Dreathwings/ESC/V1/V1.1_calque.pdf

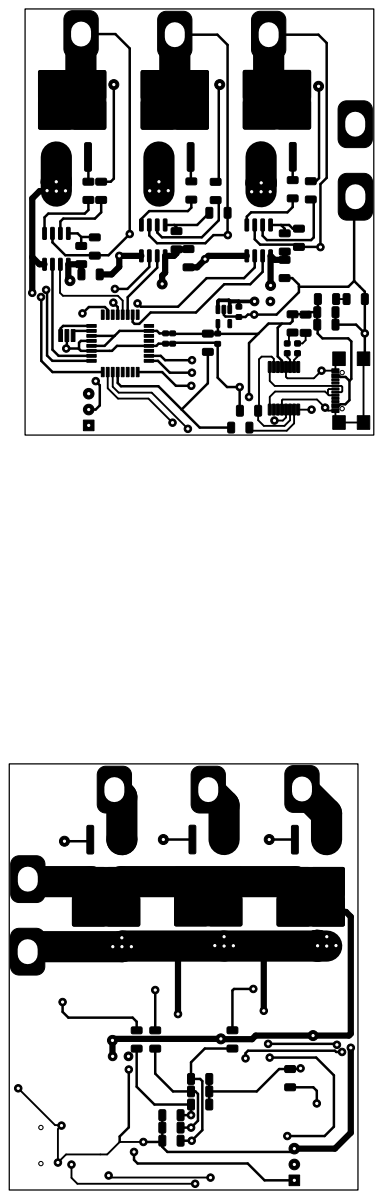
[picture p1: page 1]
