Dreathwings/ESC/V1/ESC_V1-B_Cu.pdf

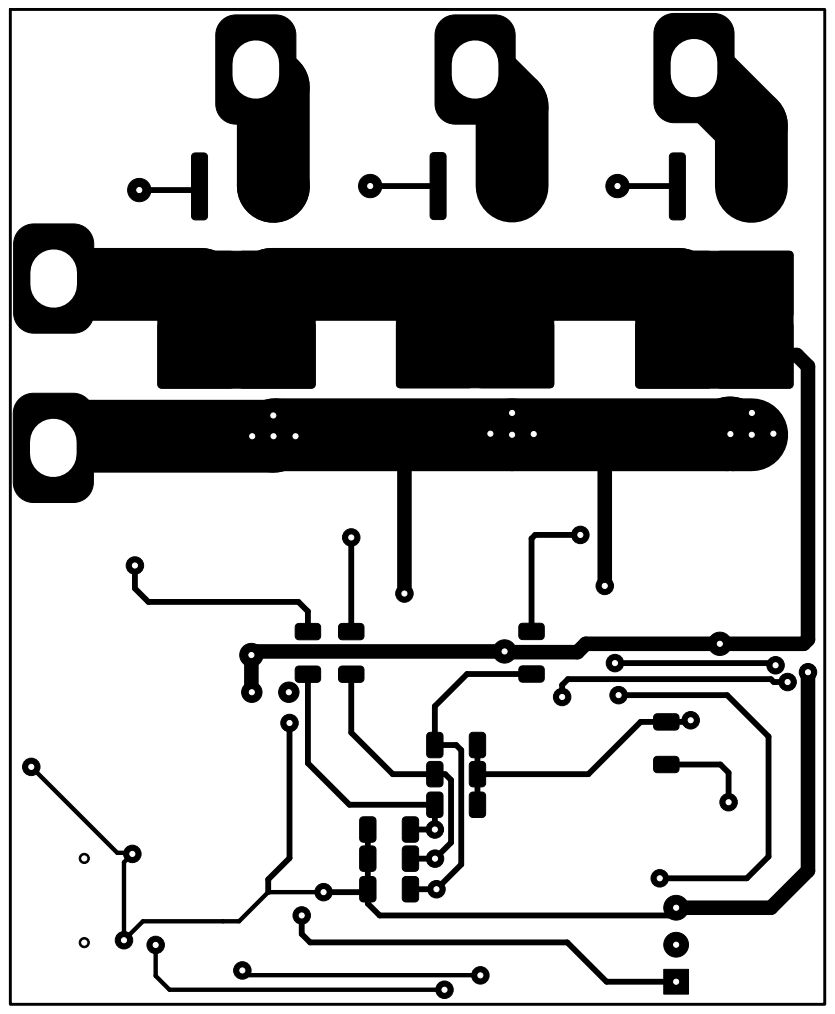
[picture p2: page 1]
