Dreathwings/ESC/V1/ESC_V1-B_Fab.pdf

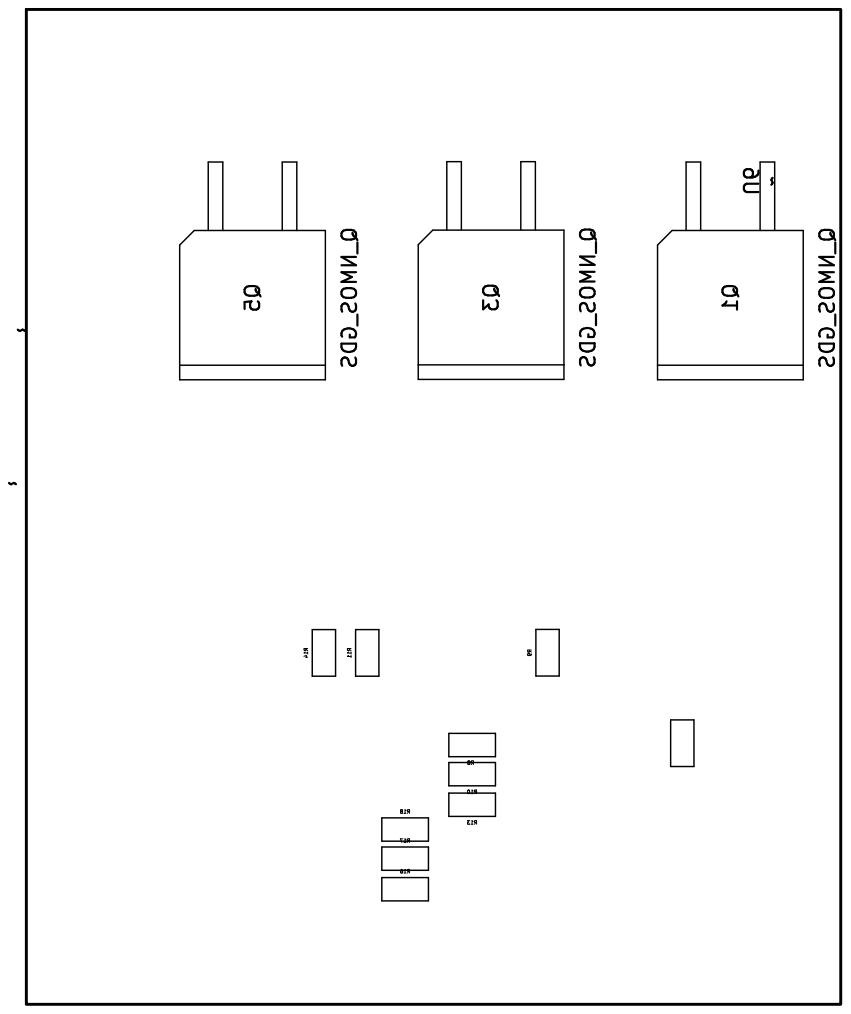
[picture p3: page 1]
