Dreathwings/ESC/V1/ESC_V1-F_Cu.pdf

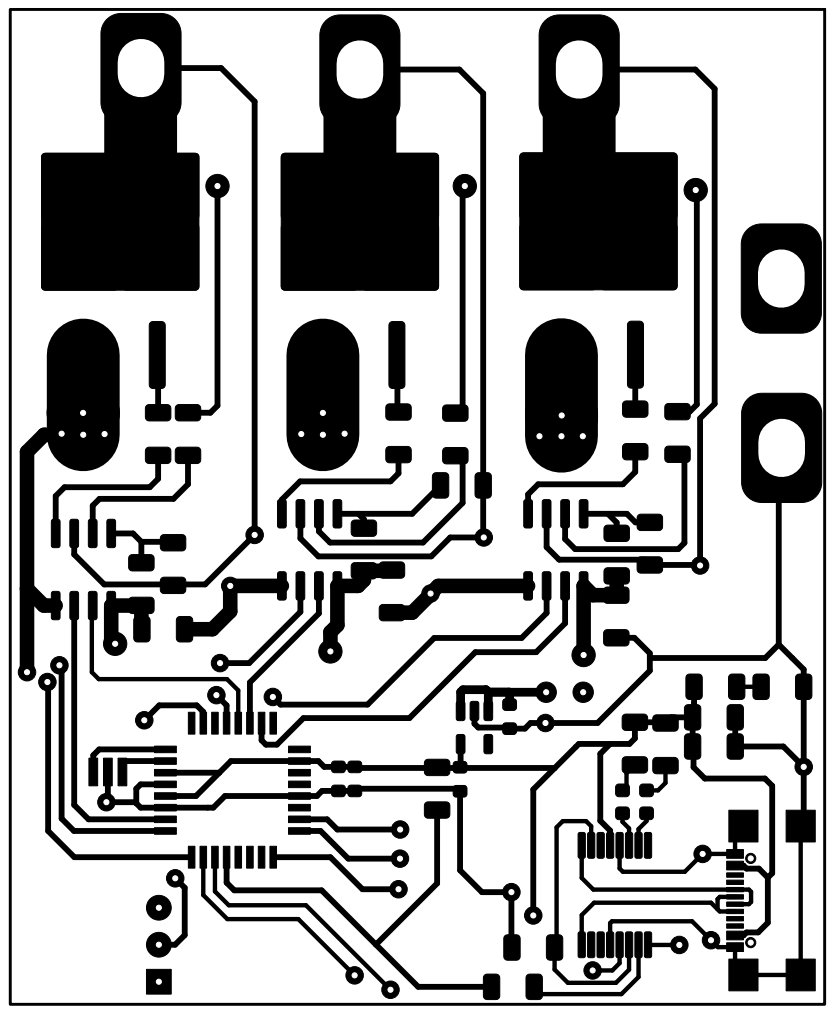
[picture p4: page 1]
