Dreathwings/ESC/V1/ESC_V1-F_Fab.pdf

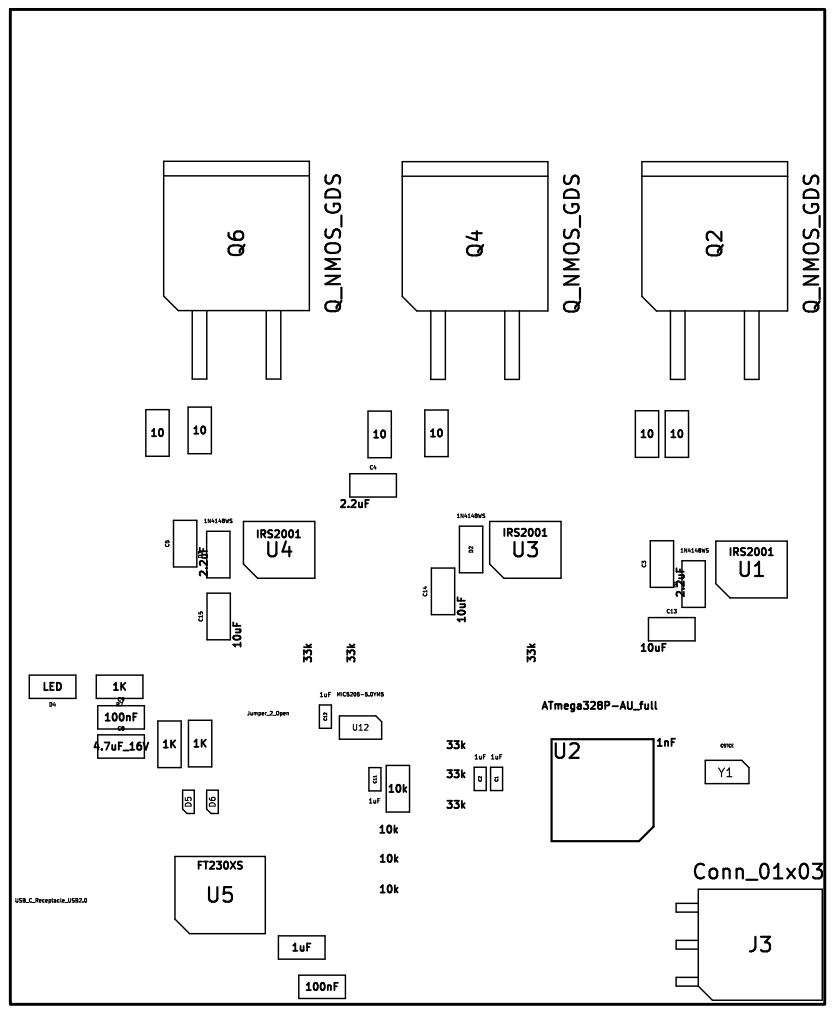
[picture p5: page 1]
