Dreathwings/ESC/V1/ESC_V1-Edge_Cuts.pdf

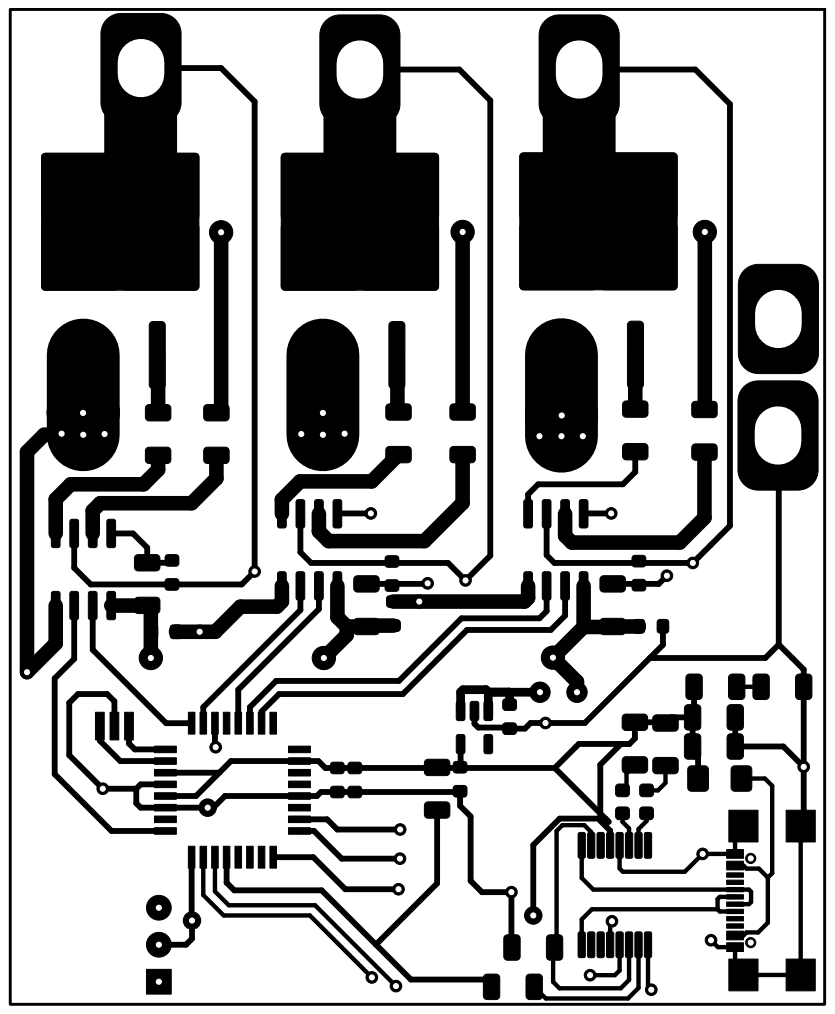
[picture p6: page 1]
