Dreathwings/ESC/V1/V1_calque.pdf

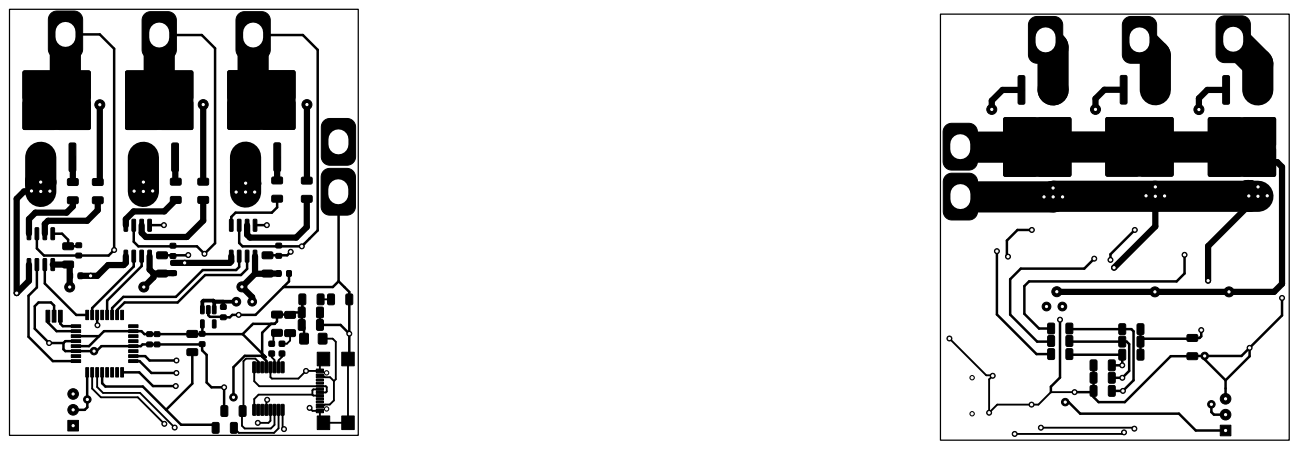
[picture p7: page 1]
