Dreathwings/ESC/V1/ESC_V1.kicad_pcb

## KiCad design V1/ESC_V1.kicad_pcb (2024-07-09, an earlier design)

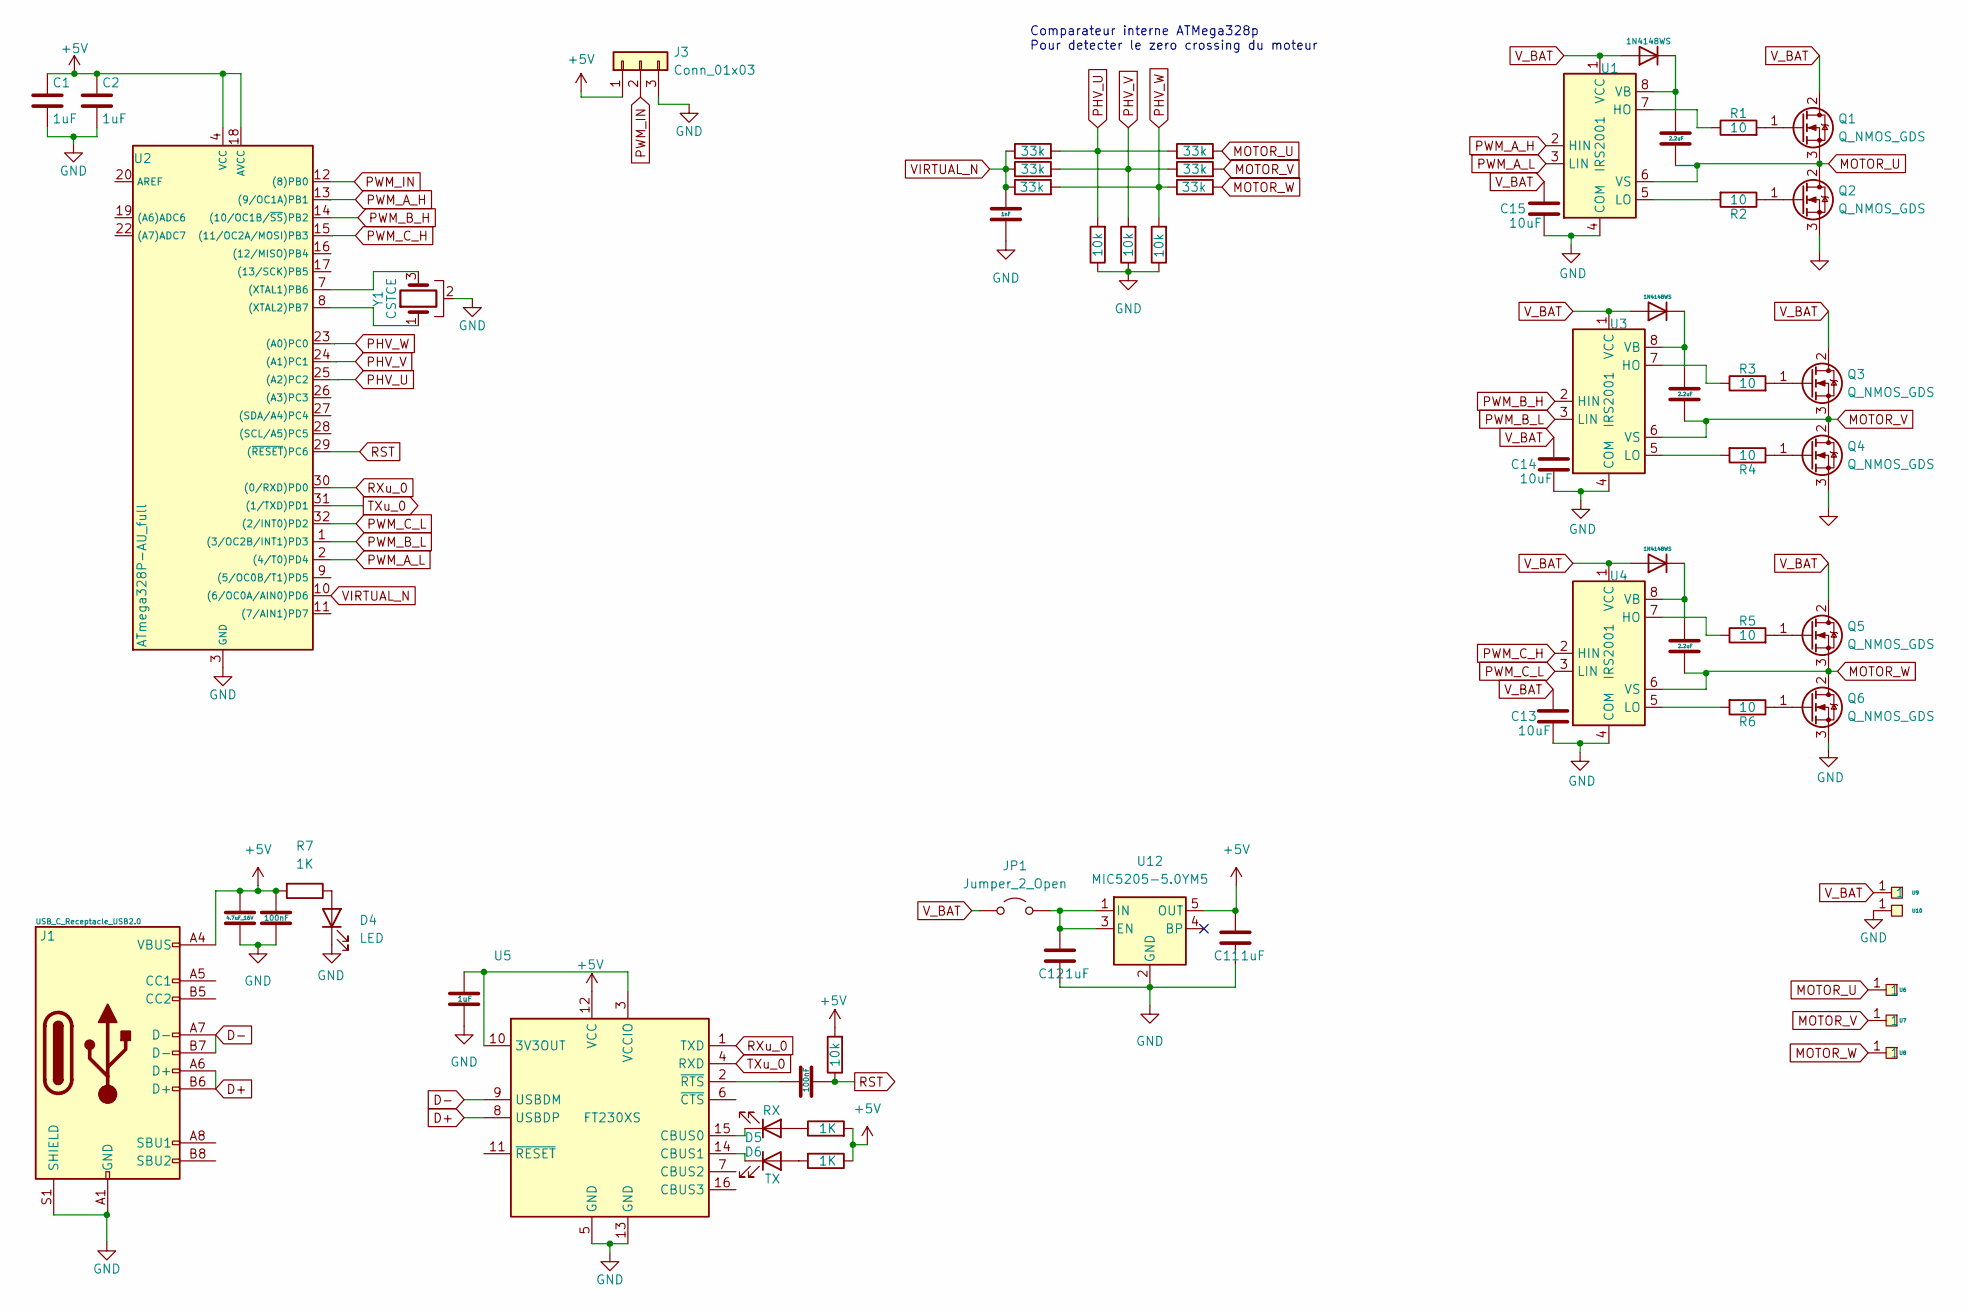
[picture p8: schematic ESC_V1.kicad_sch]

Parts:
C1, C2, C11, C12: 1uF; 0603
C3, C4, C5: 2.2uF; 1206
C6: 1uF; 1206
C7, C9: 100nF; 1206
C8: 4.7uF_16V; 1206
C10: 1nF; 1206
C13, C14, C15: 10uF; 1206
D1, D2, D3: 1N4148WS; 1206
D4: LED; 1206
D5: RX; LED_0603_1608Metric
D6: TX; LED_0603_1608Metric
J1: USB_C_Receptacle_USB2.0; USB-C USB4110_GCT
J3: Conn_01x03; PinSocket_1x03_P2.54mm_Horizontal
JP1: Jumper_2_Open; TestPoint_2Pads_Pitch2.54mm_Drill0.8mm
Q1, Q2, Q3, Q4, Q5, Q6: Q_NMOS_GDS; TO-263-2
R1, R2, R3, R4, R5, R6: 10; 1206
R7, R12, R15: 1K; 1206
R8, R9, R10, R11, R13, R14: 33k; 1206
R16, R17, R18, R19: 10k; 1206
U1, U3, U4: IRS2001; SOIC-8_3.9x4.9mm_P1.27mm
U2: ATmega328P-AU_full; TQFP32m
U5: FT230XS; SSOP-16_5.3x6.2mm_P0.65mm
U6, U7, U8, U9, U10: PAD_Connector
U12: MIC5205-5.0YM5; TSOT-23-5
Y1: CSTCE; osc_CSTCE

Connections:
+5V: C1.1, C2.1, C8.1, C9.1, C11.1, J1.A4 (VBUS), J1.A9 (VBUS), J1.B4 (VBUS), J1.B9 (VBUS), J3.1, R7.2, R12.2, R15.1, R19.2, U2.4 (VCC), U2.6 (VCC), U2.18 (AVCC), U5.12 (VCC), U12.5 (OUT)
D+: J1.A6 (D+), J1.B6 (D+), U5.8 (USBDP)
D-: J1.A7 (D-), J1.B7 (D-), U5.9 (USBDM)
GND: C1.2, C2.2, C6.1, C8.2, C9.2, C10.2, C11.2, C12.2, C13.2, C14.2, C15.2, D4.1 (K), J1.A1 (GND), J1.A12 (GND), J1.B1 (GND), J1.B12 (GND), J1.S1 (SHIELD), J3.3, Q2.3 (S), Q4.3 (S), Q6.3 (S), R16.1, R17.1, R18.1, U1.4 (COM), U2.3 (GND), U2.5 (GND), U2.21 (GND), U3.4 (COM), U4.4 (COM), U5.5 (GND), U5.13 (GND), U10.1, U12.2 (GND), Y1.2
MOTOR_U: C3.2, Q1.3 (S), Q2.2 (D), R9.2, U1.6 (VS), U6.1
MOTOR_V: C4.2, Q3.3 (S), Q4.2 (D), R11.2, U3.6 (VS), U7.1
MOTOR_W: C5.2, Q5.3 (S), Q6.2 (D), R14.2, U4.6 (VS), U8.1
unnamed: C3.1, D1.1 (K), U1.8 (VB)
unnamed: C4.1, D2.1 (K), U3.8 (VB)
unnamed: C5.1, D3.1 (K), U4.8 (VB)
unnamed: D4.2 (A), R7.1
unnamed: D5.2 (A), R12.1
unnamed: D5.1 (K), U5.15 (CBUS0)
unnamed: D6.2 (A), R15.2
unnamed: D6.1 (K), U5.14 (CBUS1)
unnamed: C12.1, JP1.2 (B), U12.1 (IN), U12.3 (EN)
unnamed: Q1.1 (G), R1.2
unnamed: Q2.1 (G), R2.1
unnamed: Q3.1 (G), R3.2
unnamed: Q4.1 (G), R4.1
unnamed: Q5.1 (G), R5.2
unnamed: Q6.1 (G), R6.1
unnamed: R1.1, U1.7 (HO)
unnamed: R2.2, U1.5 (LO)
unnamed: U2.7 ((XTAL1)PB6), Y1.3
unnamed: U2.8 ((XTAL2)PB7), Y1.1
unnamed: R3.1, U3.7 (HO)
unnamed: R4.2, U3.5 (LO)
unnamed: R5.1, U4.7 (HO)
unnamed: R6.2, U4.5 (LO)
unnamed: C6.2, U5.3 (VCCIO), U5.10 (3V3OUT)
unnamed: C7.2, U5.2 (~RTS)
PHV_U: R8.2, R9.1, R16.2, U2.25 ((A2)PC2)
PHV_V: R10.2, R11.1, R17.2, U2.24 ((A1)PC1)
PHV_W: R13.2, R14.1, R18.2, U2.23 ((A0)PC0)
PWM_A_H: U1.2 (HIN), U2.13 ((9/OC1A)PB1)
PWM_A_L: U1.3 (LIN), U2.2 ((4/T0)PD4)
PWM_B_H: U2.14 ((10/OC1B/~SS)PB2), U3.2 (HIN)
PWM_B_L: U2.1 ((3/OC2B/INT1)PD3), U3.3 (LIN)
PWM_C_H: U2.15 ((11/OC2A/MOSI)PB3), U4.2 (HIN)
PWM_C_L: U2.32 ((2/INT0)PD2), U4.3 (LIN)
PWM_IN: J3.2, U2.12 ((8)PB0)
RST: C7.1, R19.1, U2.29 ((~RESET)PC6)
RXu_0: U2.30 ((0/RXD)PD0), U5.1 (TXD)
TXu_0: U2.31 ((1/TXD)PD1), U5.4 (RXD)
VIRTUAL_N: C10.1, R8.1, R10.1, R13.1, U2.10 ((6/OC0A/AIN0)PD6)
V_BAT: C13.1, C14.1, C15.1, D1.2 (A), D2.2 (A), D3.2 (A), JP1.1 (A), Q1.2 (D), Q3.2 (D), Q5.2 (D), U1.1 (VCC), U3.1 (VCC), U4.1 (VCC), U9.1

Notes on the sheet:
Comparateur interne ATMega328p Pour detecter le zero crossing du moteur

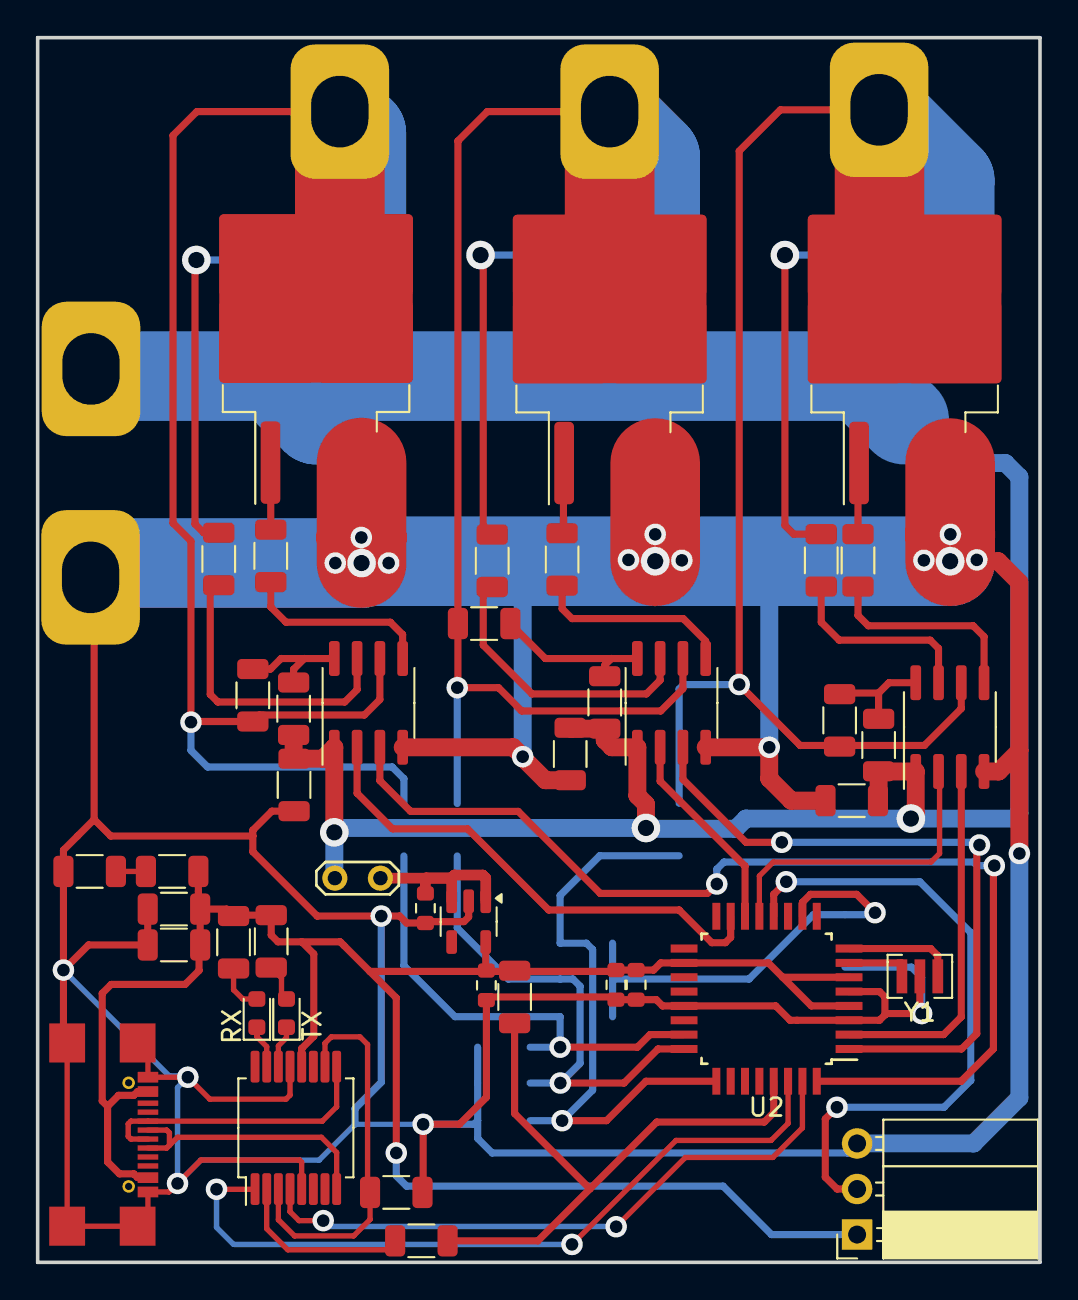
[picture p9: board ESC_V1.kicad_pcb from above]

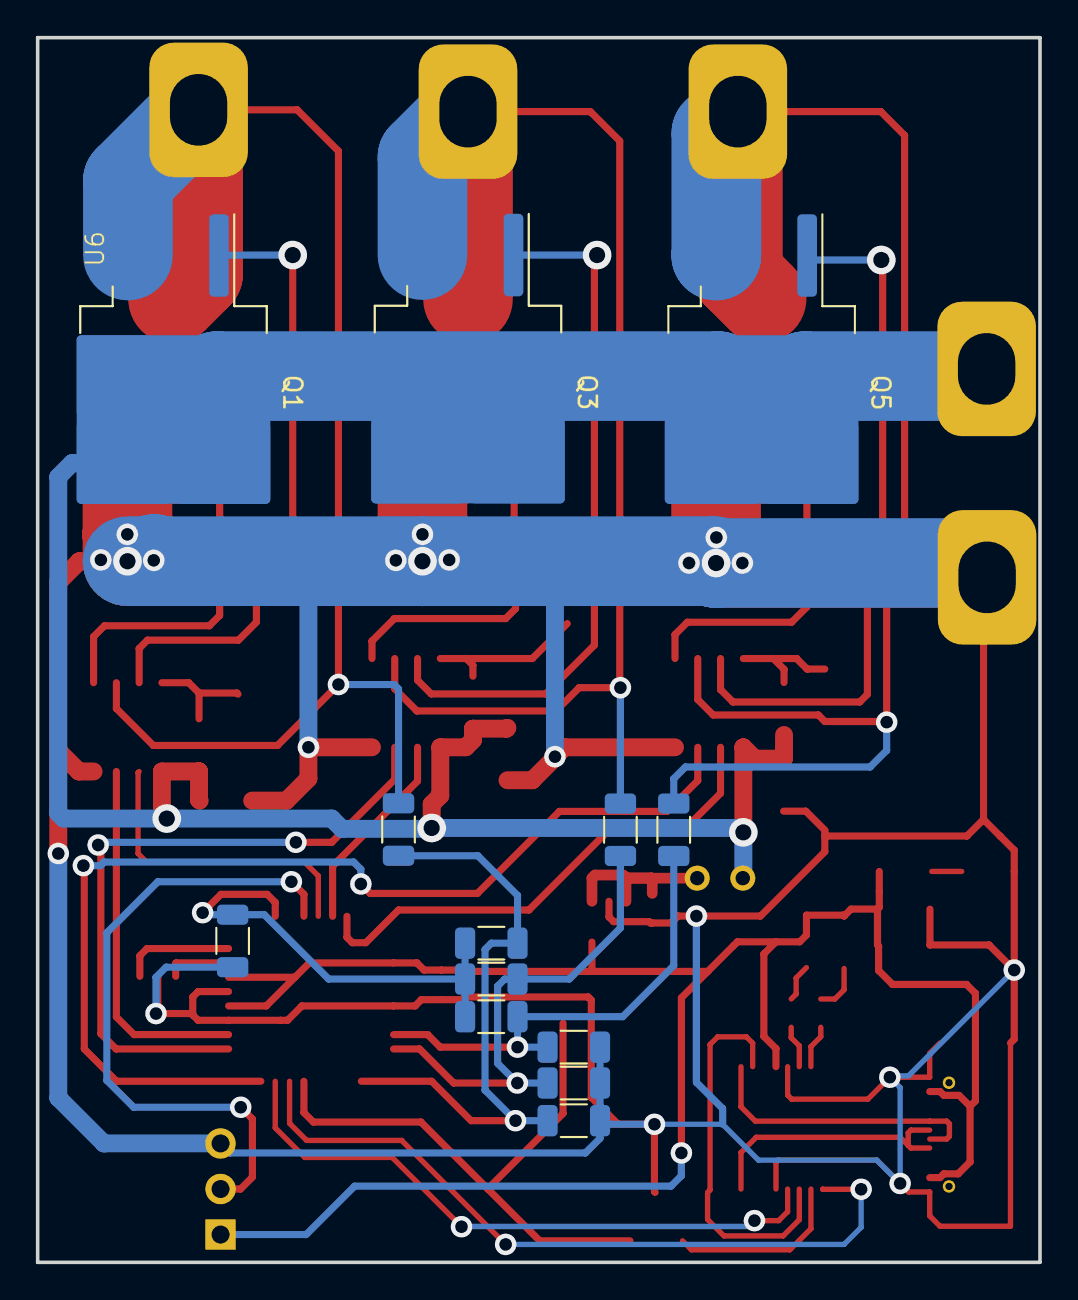
[picture p10: board ESC_V1.kicad_pcb from below]

Board: 2 copper layers, 55.9 x 68.3 mm, 61 parts (18 on the bottom side), 47 nets.
