Dreathwings/ESC/V2/ESC.kicad_pcb

## KiCad design V2/ESC.kicad_pcb (2024-07-09)

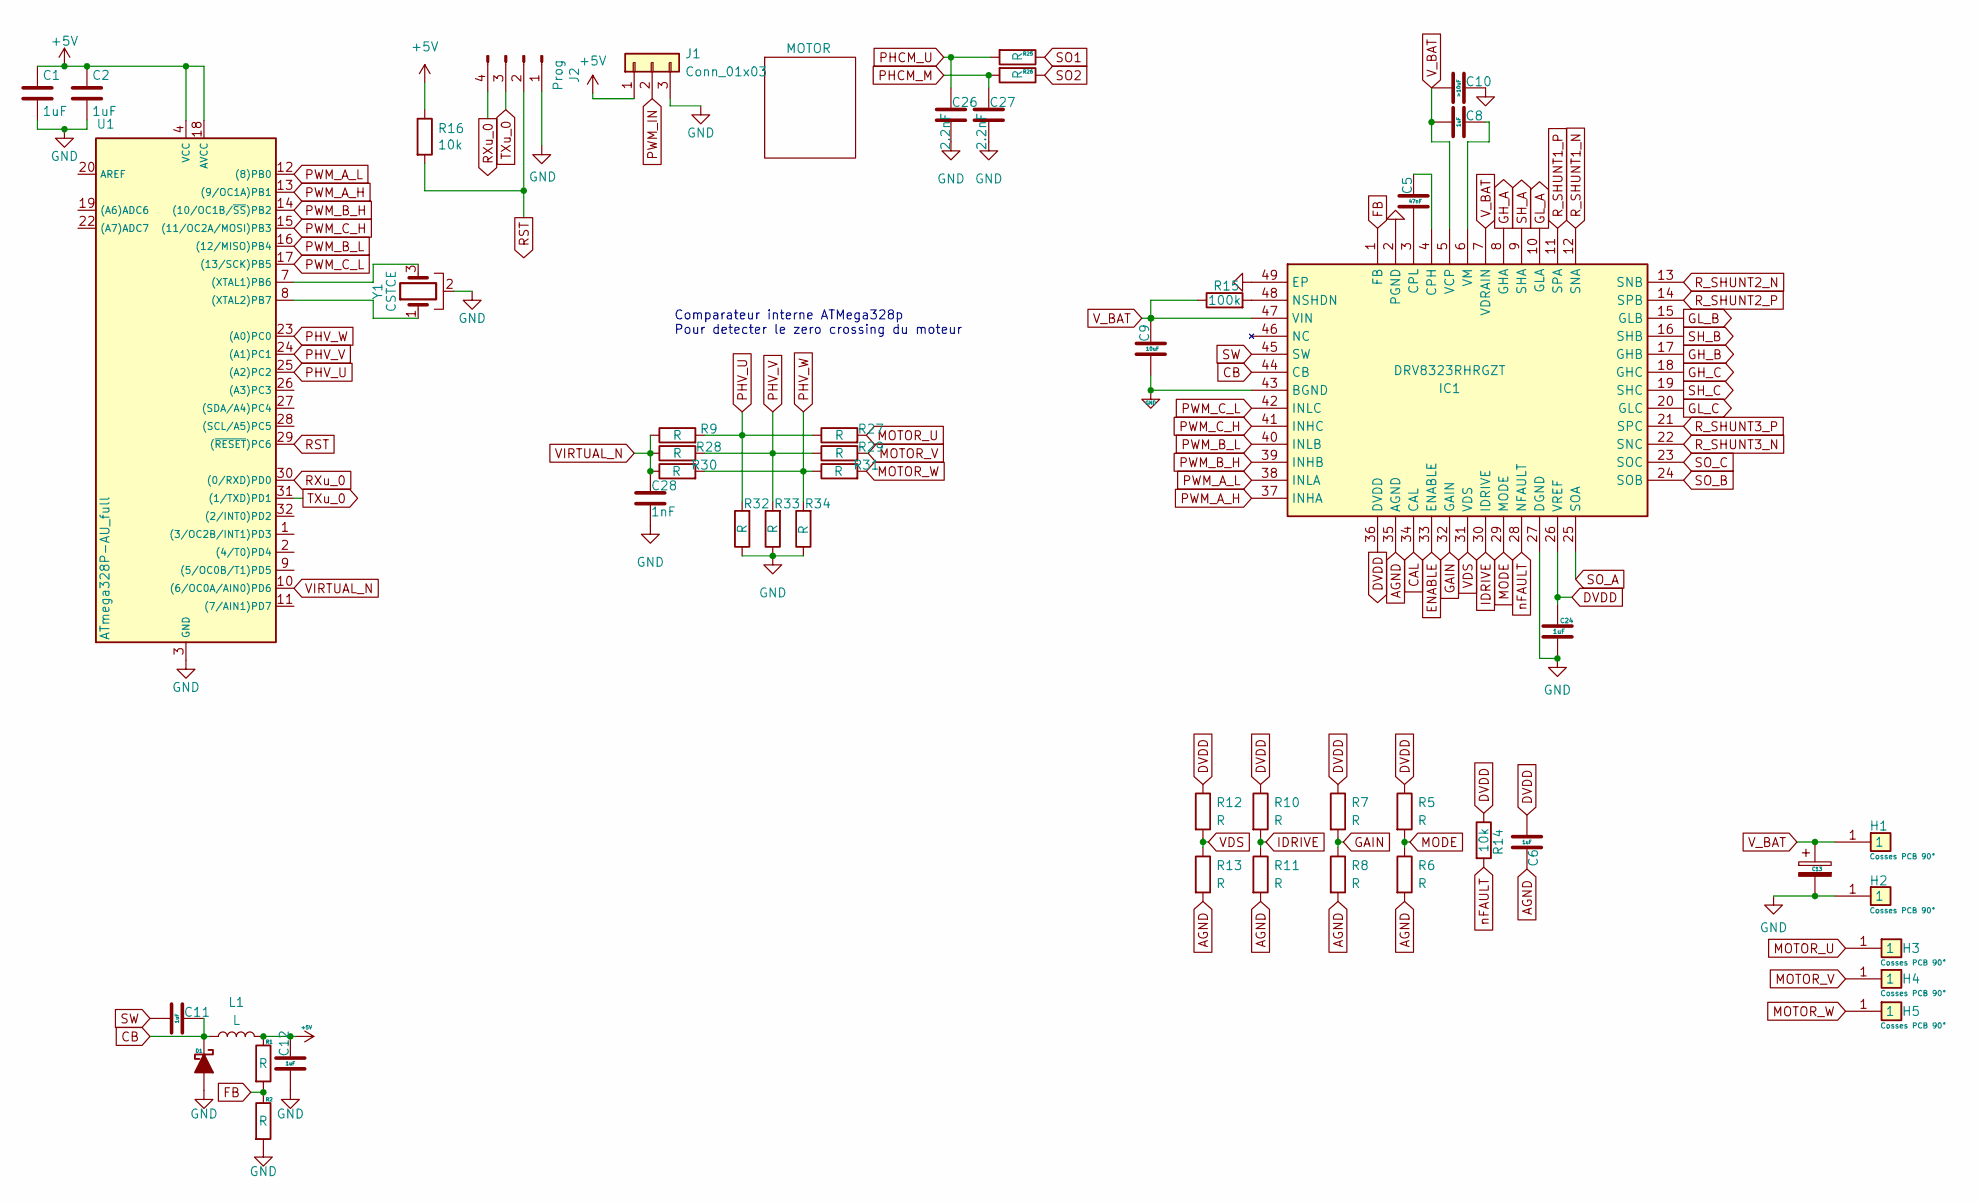
[picture p11: schematic ESC.kicad_sch]

Parts:
C1, C2, C8, C11, C12, C24: 1uF; 1206
C5: 47nF; 1206
C6: 1uF; 0603
C9: 10uF; 1206
C10: >10uF; 1206
C13: C_Polarized; CP_Radial_D18.0mm_P7.50mm
C26, C27: 2.2nF; 1206
C28: 1nF; 1206
D1: D_Schottky_Filled; 1206
H1, H2, H3, H4, H5: Cosses PCB 90°; 12177561; Manufacturer_Part_Number 1217756-1
IC1: DRV8323RHRGZT; Mouser Part Number 595-DRV8302DCA
J1: Conn_01x03; PinSocket_1x03_P2.54mm_Horizontal
J2: Prog; PinHeader_1x04_P2.54mm_Vertical
L1: L; L_Ferrocore_DLG-1005
R1, R2, R9, R27, R28, R29, R30, R31, R32, R33, R34: R; 1206
R5, R6, R7, R8, R10, R11, R12, R13, R25, R26: R; 0603
R14: 10k; 0603
R15: 100k; 1206
R16: 10k; 1206
U1: ATmega328P-AU_full; TQFP32m
Y1: CSTCE; osc_CSTCE

Connections:
+5V: C1.1, C2.1, C12.1, J1.1, L1.2, R1.1, R16.1, U1.4 (VCC), U1.6 (VCC), U1.18 (AVCC)
AGND: C6.1, IC1.35 (AGND), R6.2, R8.2, R11.2, R13.2
CAL: IC1.34 (CAL)
CB: C11.1, D1.1 (K), IC1.44 (CB), L1.1
DVDD: C6.2, C24.1, IC1.26 (VREF), IC1.36 (DVDD), R5.1, R7.1, R10.1, R12.1, R14.1
ENABLE: IC1.33 (ENABLE)
FB: IC1.1 (FB), R1.2, R2.1
GAIN: IC1.32 (GAIN), R7.2, R8.1
GH_A: IC1.8 (GHA); also elsewhere on the board
GH_B: IC1.17 (GHB); also elsewhere on the board
GH_C: IC1.18 (GHC); also elsewhere on the board
GL_A: IC1.10 (GLA); also elsewhere on the board
GL_B: IC1.15 (GLB); also elsewhere on the board
GL_C: IC1.20 (GLC); also elsewhere on the board
GND: C1.2, C2.2, C9.2, C10.1, C12.2, C13.2, C24.2, C26.2, C27.2, C28.2, D1.2 (A), H2.1, IC1.2 (PGND), IC1.12 (SNA), IC1.13 (SNB), IC1.22 (SNC), IC1.27 (DGND), IC1.43 (BGND), IC1.49 (EP), J1.3, J2.1, R2.2, R32.1, R33.1, R34.1, U1.3 (GND), U1.5 (GND), U1.21 (GND), Y1.2; also elsewhere on the board
IDRIVE: IC1.30 (IDRIVE), R10.2, R11.1
MODE: IC1.29 (MODE), R5.2, R6.1
MOTOR_U: H3.1, IC1.9 (SHA), R27.2; also elsewhere on the board
MOTOR_V: H4.1, IC1.16 (SHB), R29.2; also elsewhere on the board
MOTOR_W: H5.1, IC1.19 (SHC), R31.2; also elsewhere on the board
unnamed: C5.1, IC1.4 (CPH)
unnamed: C5.2, IC1.3 (CPL)
unnamed: IC1.48 (NSHDN), R15.2
unnamed: C8.1, IC1.6 (VM)
unnamed: U1.7 ((XTAL1)PB6), Y1.3
unnamed: U1.8 ((XTAL2)PB7), Y1.1
PHCM_M: C27.1, R26.2
PHCM_U: C26.1, R25.2
PHV_U: R9.2, R27.1, R32.2, U1.25 ((A2)PC2)
PHV_V: R28.2, R29.1, R33.2, U1.24 ((A1)PC1)
PHV_W: R30.2, R31.1, R34.2, U1.23 ((A0)PC0)
PWM_A_H: IC1.37 (INHA), U1.13 ((9/OC1A)PB1)
PWM_A_L: IC1.38 (INLA), U1.12 ((8)PB0)
PWM_B_H: IC1.39 (INHB), U1.14 ((10/OC1B/~SS)PB2)
PWM_B_L: IC1.40 (INLB), U1.16 ((12/MISO)PB4)
PWM_C_H: IC1.41 (INHC), U1.15 ((11/OC2A/MOSI)PB3)
PWM_C_L: IC1.42 (INLC), U1.17 ((13/SCK)PB5)
PWM_IN: J1.2
RST: J2.2, R16.2, U1.29 ((~RESET)PC6)
RXu_0: J2.4, U1.30 ((0/RXD)PD0)
R_SHUNT1_P: IC1.11 (SPA); also elsewhere on the board
R_SHUNT2_P: IC1.14 (SPB); also elsewhere on the board
R_SHUNT3_P: IC1.21 (SPC); also elsewhere on the board
SO1: R25.1
SO2: R26.1
SO_A: IC1.25 (SOA)
SO_B: IC1.24 (SOB)
SO_C: IC1.23 (SOC)
SW: C11.2, IC1.45 (SW)
TXu_0: J2.3, U1.31 ((1/TXD)PD1)
VDS: IC1.31 (VDS), R12.2, R13.1
VIRTUAL_N: C28.1, R9.1, R28.1, R30.1, U1.10 ((6/OC0A/AIN0)PD6)
V_BAT: C8.2, C9.1, C10.2, C13.1, H1.1, IC1.5 (VCP), IC1.7 (VDRAIN), IC1.47 (VIN), R15.1; also elsewhere on the board
nFAULT: IC1.28 (NFAULT), R14.2

Notes on the sheet:
Comparateur interne ATMega328p Pour detecter le zero crossing du moteur

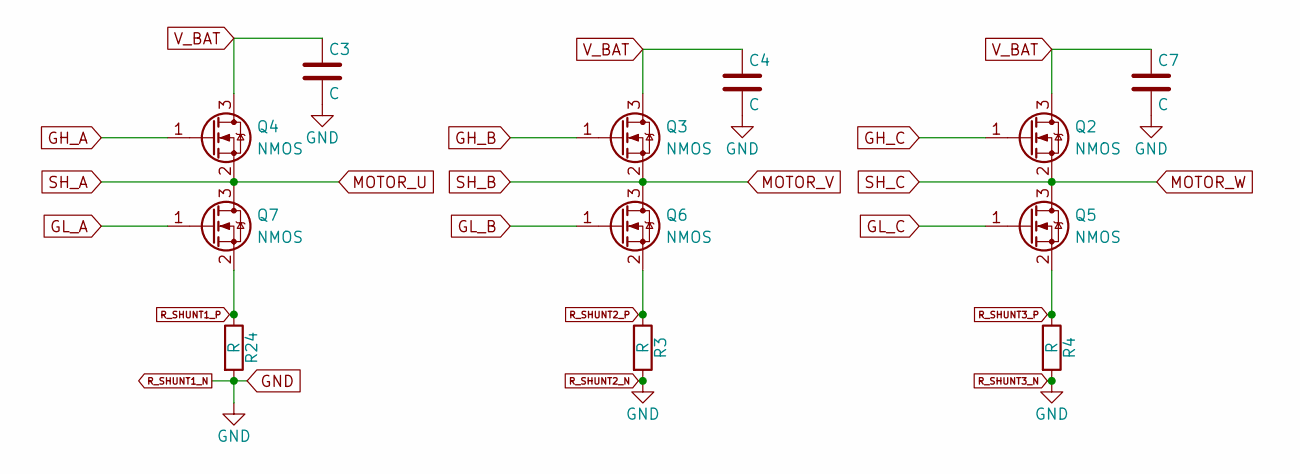
[picture p12: schematic untitled.kicad_sch]

Parts:
C3, C4, C7: C; 1206
Q2, Q3, Q4, Q5, Q6, Q7: NMOS; D2PAK
R3, R4, R24: R; R_Shunt_Vishay_WSR2_WSR3

Connections:
GH_A: Q4.1 (G); also elsewhere on the board
GH_B: Q3.1 (G); also elsewhere on the board
GH_C: Q2.1 (G); also elsewhere on the board
GL_A: Q7.1 (G); also elsewhere on the board
GL_B: Q6.1 (G); also elsewhere on the board
GL_C: Q5.1 (G); also elsewhere on the board
GND: C3.2, C4.2, C7.2, R3.2, R4.2, R24.2; also elsewhere on the board
MOTOR_U: Q4.2 (S), Q7.3 (D); also elsewhere on the board
MOTOR_V: Q3.2 (S), Q6.3 (D); also elsewhere on the board
MOTOR_W: Q2.2 (S), Q5.3 (D); also elsewhere on the board
R_SHUNT1_P: Q7.2 (S), R24.1; also elsewhere on the board
R_SHUNT2_P: Q6.2 (S), R3.1; also elsewhere on the board
R_SHUNT3_P: Q5.2 (S), R4.1; also elsewhere on the board
V_BAT: C3.1, C4.1, C7.1, Q2.3 (D), Q3.3 (D), Q4.3 (D); also elsewhere on the board

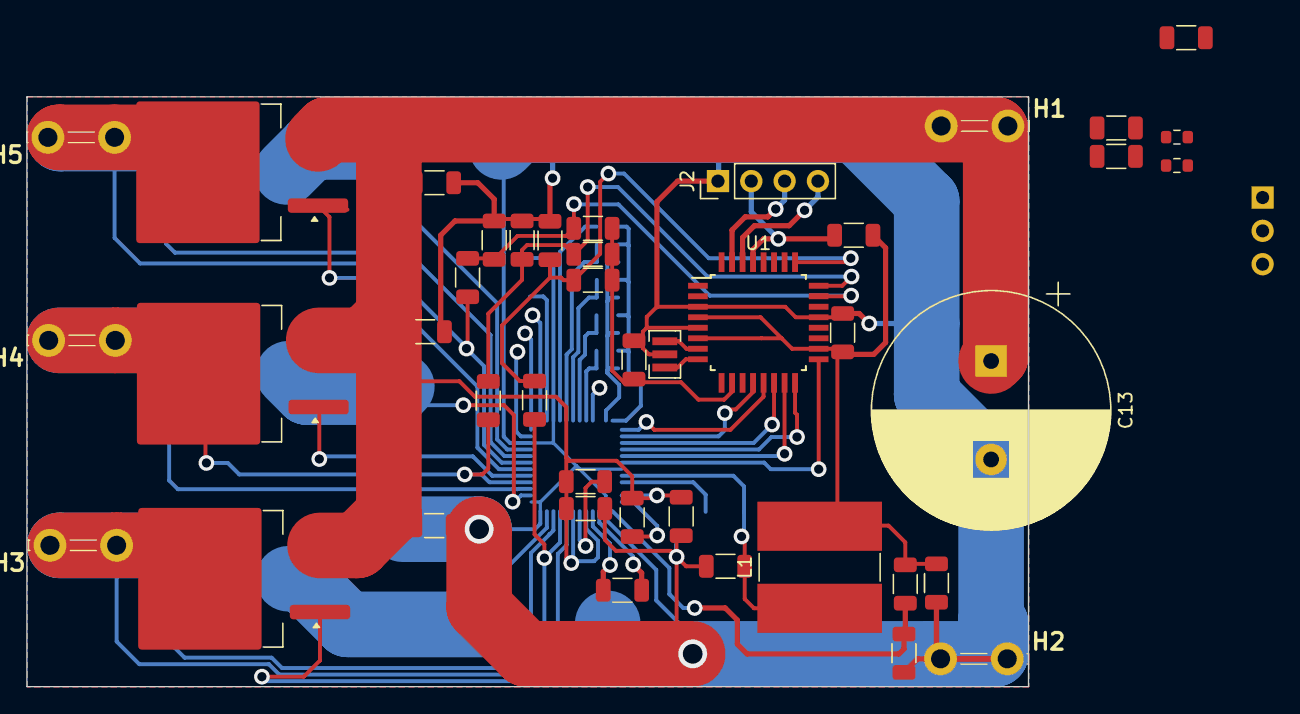
[picture p13: board ESC.kicad_pcb from above]

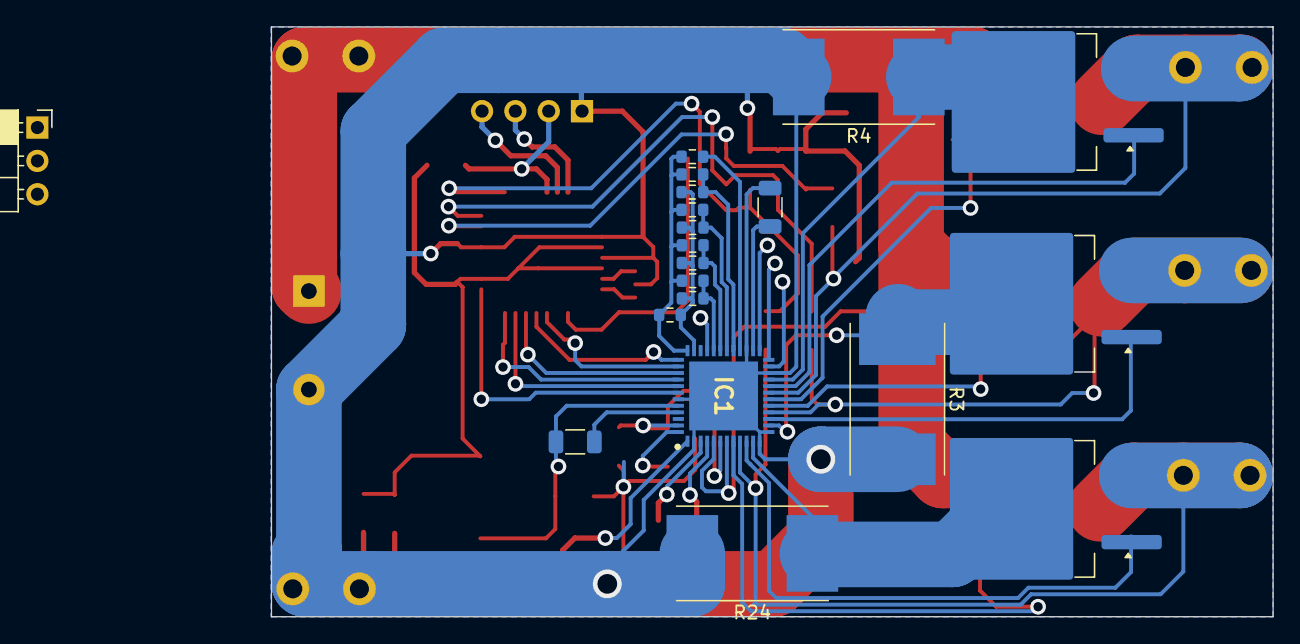
[picture p14: board ESC.kicad_pcb from below]

Board: 2 copper layers, 76.3 x 44.9 mm, 62 parts (20 on the bottom side), 46 nets.
